volab/permisC2019/readme.rst

Infos générales Projet permis C 2019
======================================

   :Auteur:            `VoLAB <https://github.com/volab>`_
   :Projet:             Permis C 2019
   :dépôt_GitHub:       https://github.com/volab/permisC2019.git
   :documentation:      https://volab.github.io/permisC2019/ 
   :Licence:            CC BY-NC-SA 4.0
   :Liens:              https://creativecommons.org/licenses/by-nc-sa/4.0/ 

------------------------------------------------------------------------------------------
