volab/permisC2019/_01-docs/_01-userDoc/fiches_peda_pcb_sansvariable/robot_junior_ressource5.odt

(http://www.vorobotics.com/) Ressource numéro 5 Doc 1/1
Robot Junior | Comment développer un robot autonome ?

Découverte des actionneurs

Les moteurs à courant continu

Le déplacement du robot

Nous allons découvrir les moteurs à courant continu

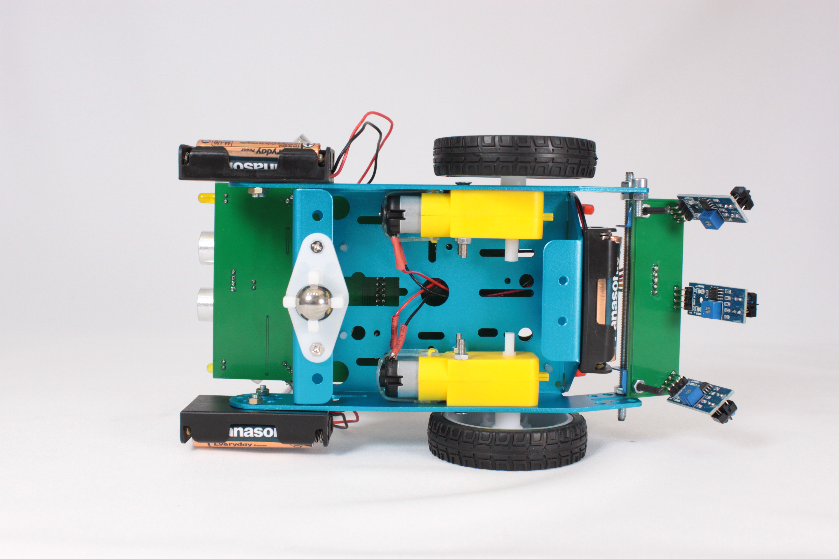
[picture p23: figure]

Moteur droit broche 12 (PWM)

Moteur droit broche 45 (sens 1 ou 0)

Moteur gauche broche 44 (PWM)

Moteur gauche broche 46 (sens 1 ou 0)

Le robot avance 1 seconde, s’arrête 1 seconde, recule 1 seconde et ensuite s’arrête 1 seconde. Le cycle se répète indéfiniment

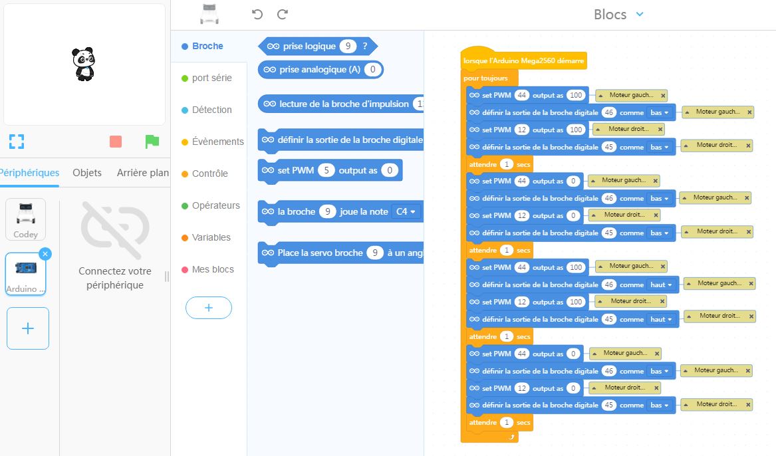
[picture p24: figure]

Association VoRoBotics
