volab/permisC2019/_02-realisation/_01-software/robot_junior_prog_maquette/programme de présentation.odt

Avancer

LEDs Avant

Obstacle Avant

Distance de sécurité (inertie)

Arrêt + feux Stop (LEDs Arrières)

Obstacle Avant

Reculer Ligne droite (distance aléatoire entre min et max)

LEDs Arrière + Buzzer

Obstacle Arrière

Arrêt + feux Stop (LEDs Arrière)

Retourner (orientation aléatoire entre min et max)

LEDs droites / gauches + Buzzer

Obstacle Arrière

Arrêt + feux Stop (LEDs Arrière)

Avancer

LEDs Avant
