volab/permisC2019/_01-docs/_01-userDoc/fiches_peda/doc_peda_pdf/robot_junior_ressource2.pdf

## Ressource numéro 2

## Découverte des actionneurs

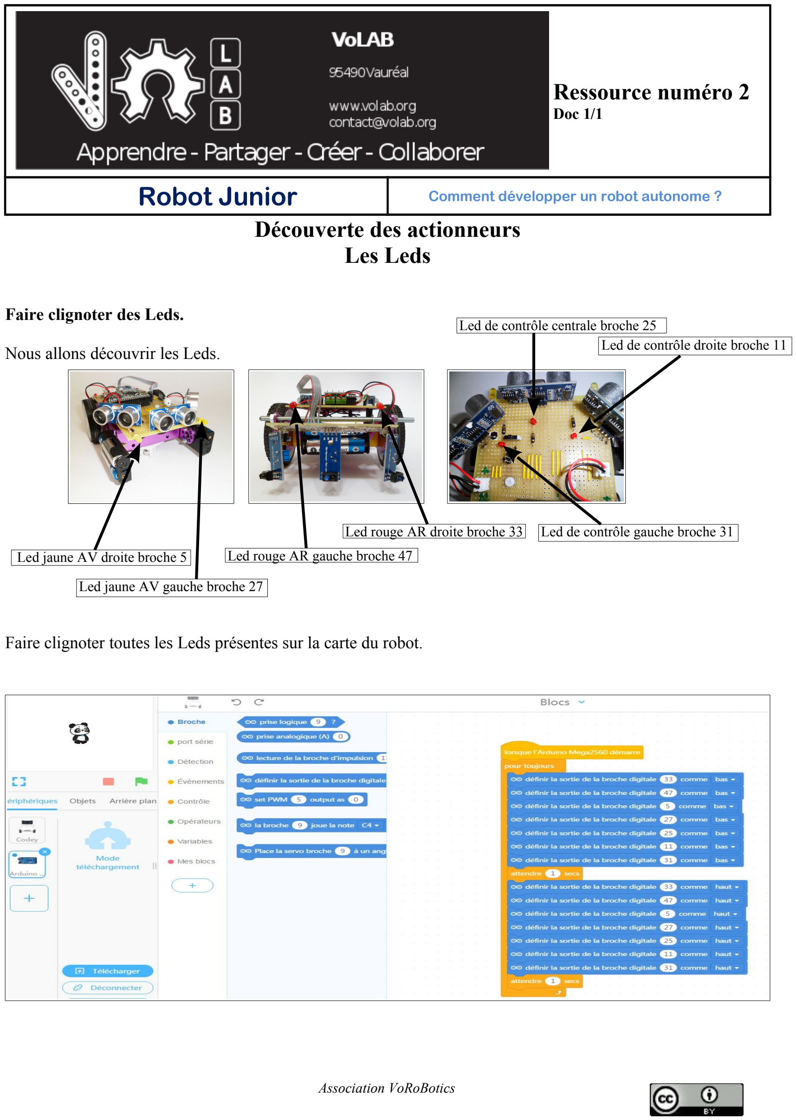
[picture p35: page 1]

Doc 1/1

Robot Junior | Comment développer un robot autonome ?

## Les Leds

Faire clignoter des Leds.

Nous allons découvrir les Leds.

Faire clignoter toutes les Leds présentes sur la carte du robot.

Association VoRoBotics

Led jaune AV droite broche 5

Led jaune AV gauche broche 27

Led rouge AR droite broche 33 Led rouge AR gauche broche 47

Led de contrôle centrale broche 25 Led de contrôle droite broche 11

Led de contrôle gauche broche 31
