volab/permisC2019/_01-docs/_01-userDoc/fiches_peda/doc_peda_pdf/robot_junior_ressource5.pdf

## Ressource numéro 5

## Découverte des actionneurs

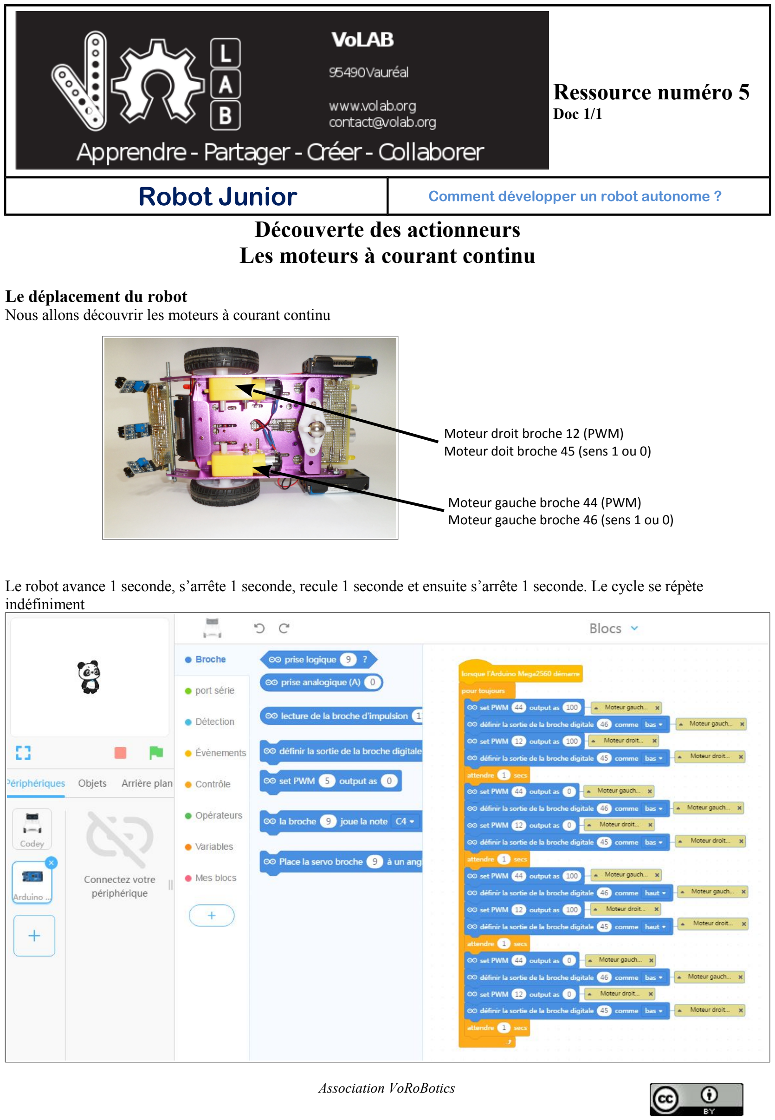
[picture p38: page 1]

Doc 1/1

Robot Junior | Comment développer un robot autonome ?

## Les moteurs à courant continu

Le déplacement du robot
Nous allons découvrir les moteurs à courant continu

Le robot avance 1 seconde, s’arrête 1 seconde, recule 1 seconde et ensuite s’arrête 1 seconde. Le cycle se répète indéfiniment

Association VoRoBotics

Moteur gauche broche 44 (PWM) Moteur gauche broche 46 (sens 1 ou 0)

Moteur droit broche 12 (PWM) Moteur doit broche 45 (sens 1 ou 0)
