volab/permisC2019/_01-docs/_01-userDoc/readme.rst

Dossier documentation du projet permis C 2019
===============================================

Voici l'arboresences du dossier _01-userDoc du projet:

.. code::

    +---fiches_peda
    |   |   
    |   +---doc_peda_pdf
    |   |       
    |   \---photos_robot
    |           
    +---fiches_peda_pcb_sansvariable
    |   |   
    |   +---photos_robot
    |   |       
    |   \---doc_peda_pcb_sansvariable_pdf
    |       |   
    |       \---monoPDF
    |               fiches_peda_merged.pdf
    |               
    \---documentionProjetToWeb

fiches_peda : contient la premeière version des fiches pédagogiques (celle de la maquette)

fiches_peda_pcb_sansvariable : contient les fiches de la version PCB et qui n'utilise pas 
de variables

documentionProjetToWeb : contient les fichiers sources de la documentation à destination de 
Github pages et transformées en html par Sphinx (cf https://github.com/poltergeist42/JDM )
