volab/permisC2019/_01-docs/_05-administratif/readme.rst

Dossier administratif du projet permisC 2019
==============================================
Ce dossier contient des documents permettant de gérer les ateliers du samedi matin.

Parmis les documetns intéressant on y trouve les sources aillant servi pour l'affiche et/ou flyer.
