volab/permisC2019/_01-docs/_01-userDoc/fiches_peda/robot_junior_ressource4.odt

(http://www.vorobotics.com/) Ressource numéro 4 Doc 1/1
Robot Junior | Comment développer un robot autonome ?

Découverte des actionneurs

Le buzzer

Faire sonner un buzzer

Nous allons découvrir le buzzer

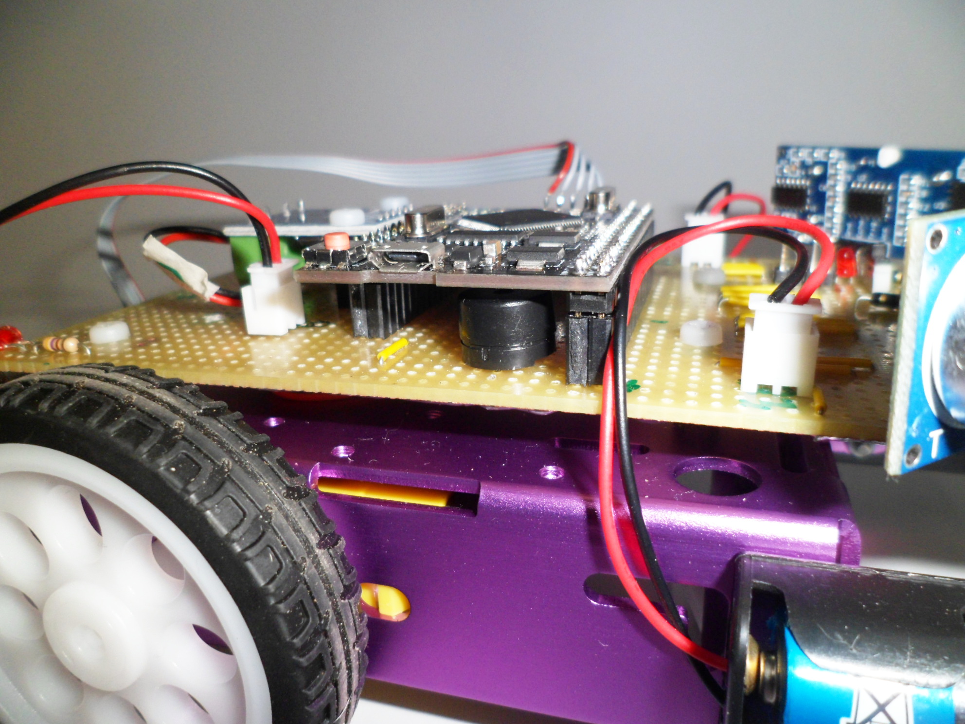
[picture p44: figure]

Buzzer

(raccordées sur la broche 4 de la carte)

Faire sonner le buzzer une seconde et l’éteindre.

Association VoRoBotics
