volab/permisC2019/_01-docs/_05-administratif/afficheA3_190903_2255.pdf

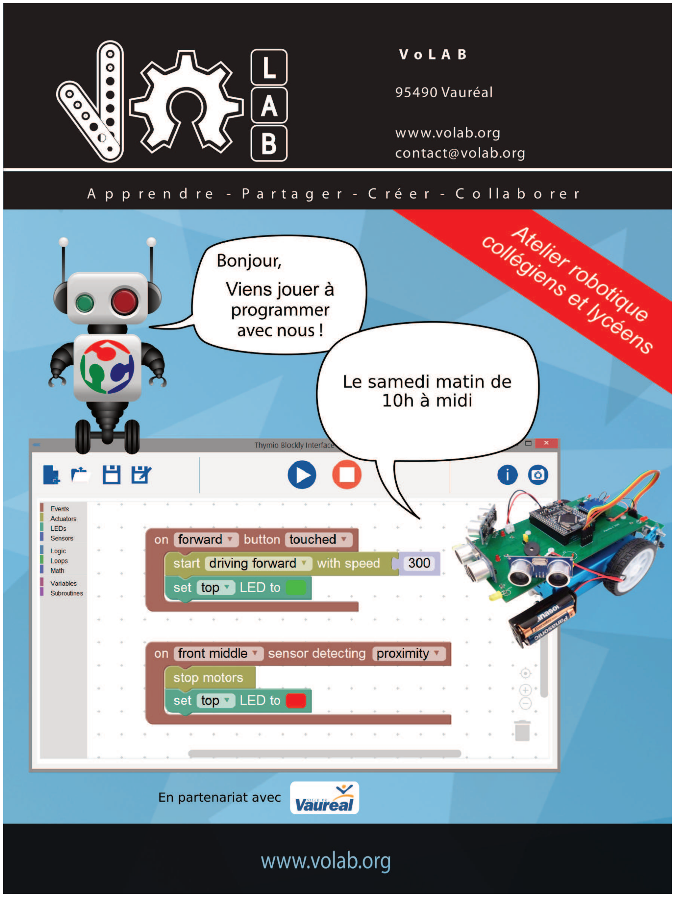
[picture p45: page 1]
