volab/permisC2019/_01-docs/_05-administratif/flyer_190903_2255.pdf

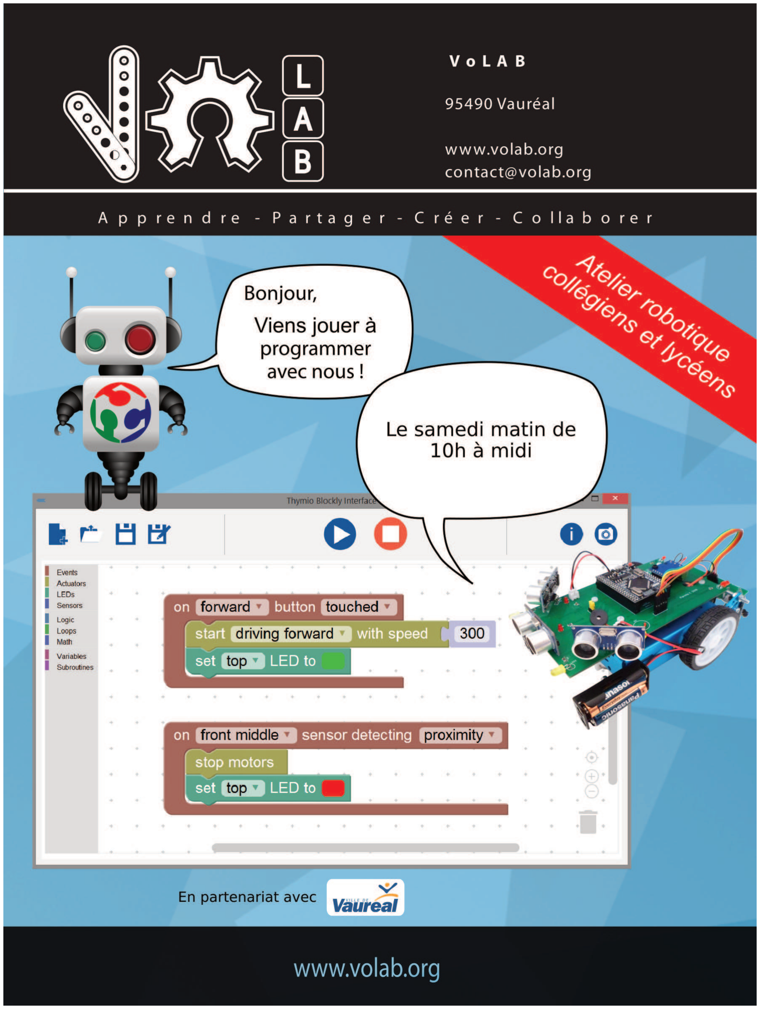
[picture p46: figure]
