volab/permisC2019/_01-docs/_01-userDoc/fiches_peda_pcb_sansvariable/doc_peda_pcb_sansvariable_pdf/robot_junior_ressource6.pdf

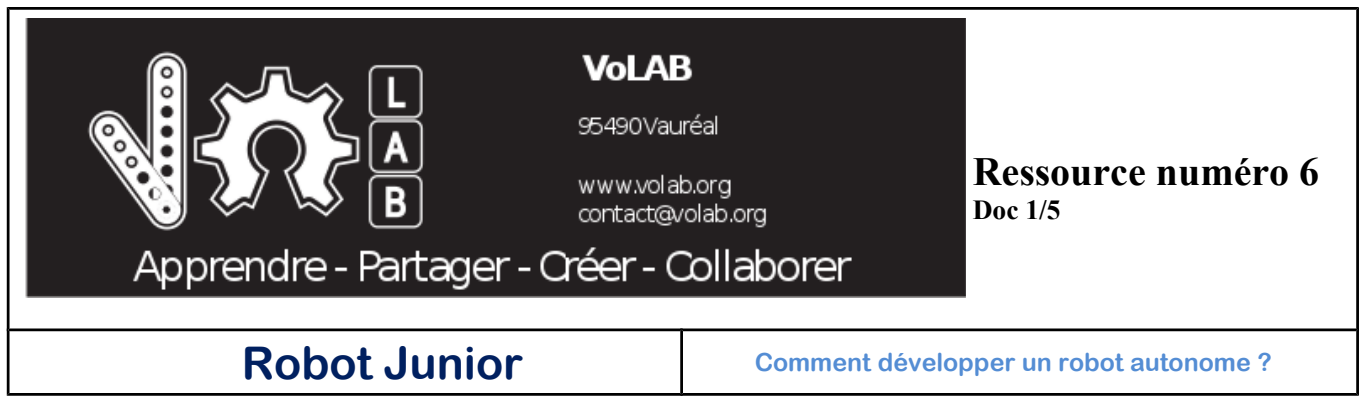
[picture p47: figure]
Ressource numéro 6; Doc 1/5

Robot Junior | Comment développer un robot autonome ?

## Programme final

Création des variables

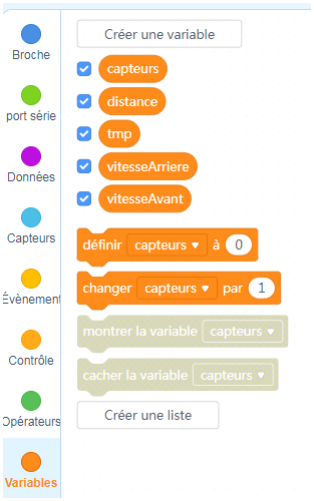
[picture p48: figure]

Association VoRoBotics

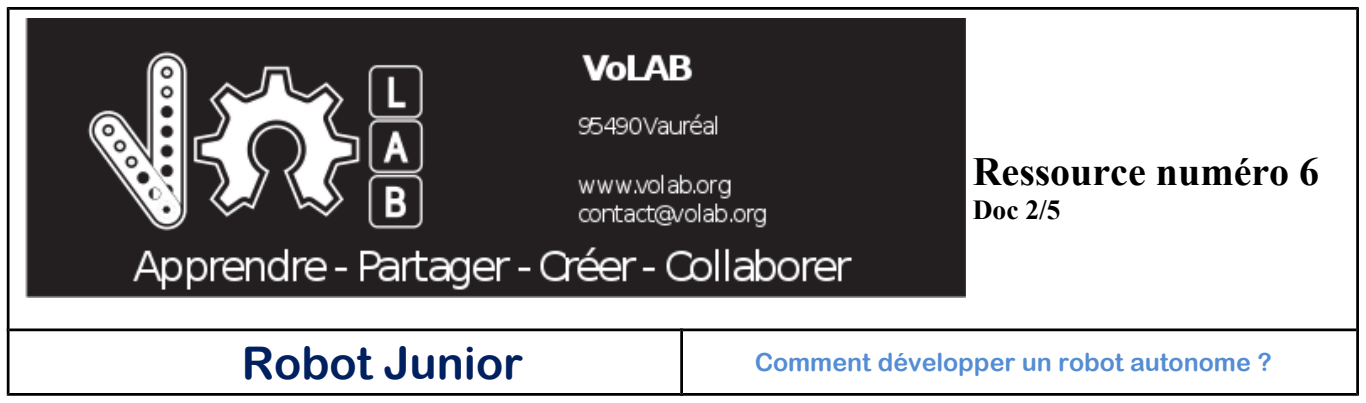
[picture p49: figure]
Ressource numéro 6; Doc 2/5

Robot Junior | Comment développer un robot autonome ?

Créer les blocs de détection

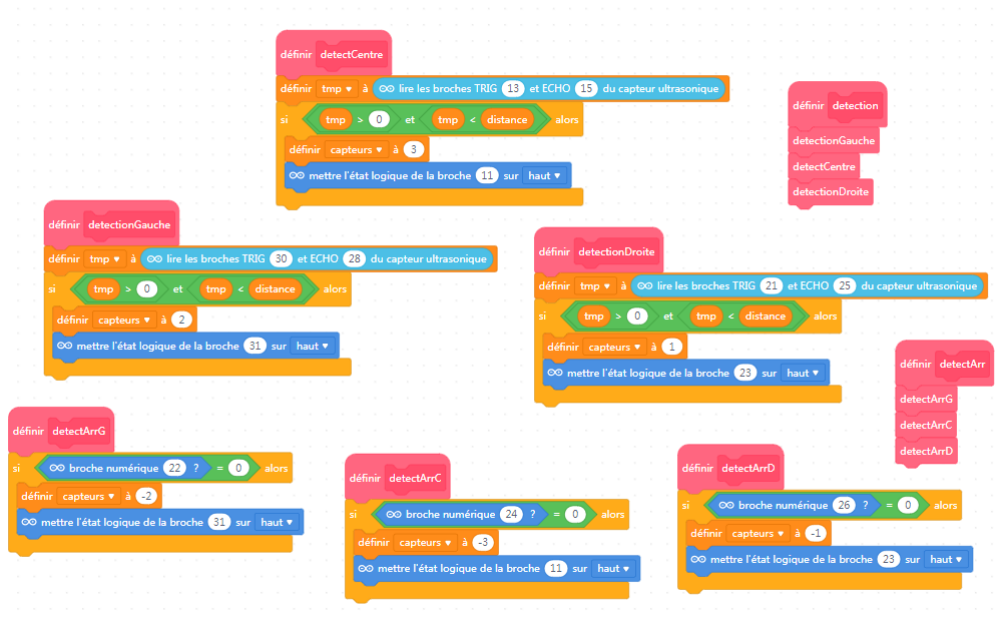
[picture p50: figure]

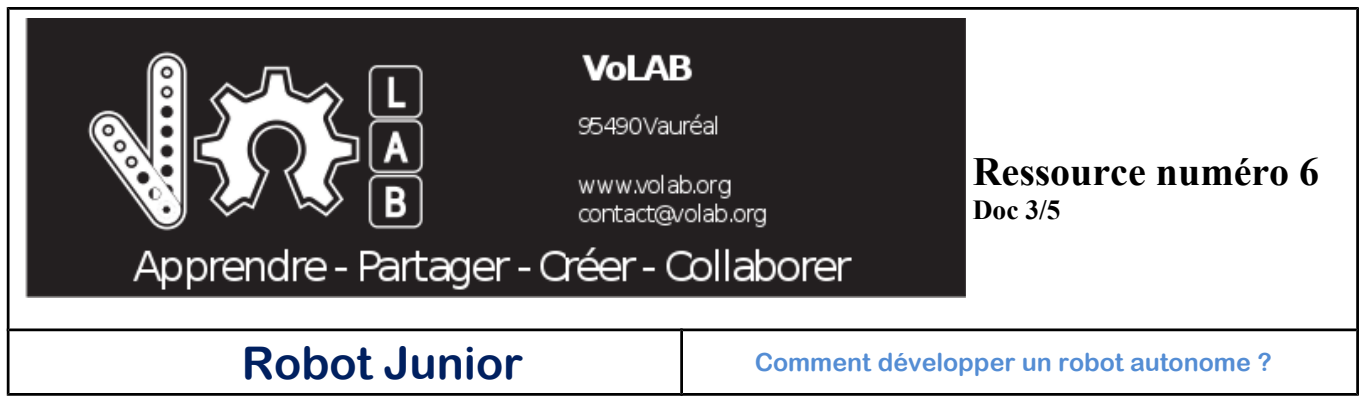
[picture p51: figure]
Ressource numéro 6; Doc 3/5

Robot Junior | Comment développer un robot autonome ?

Les blocs moteurs

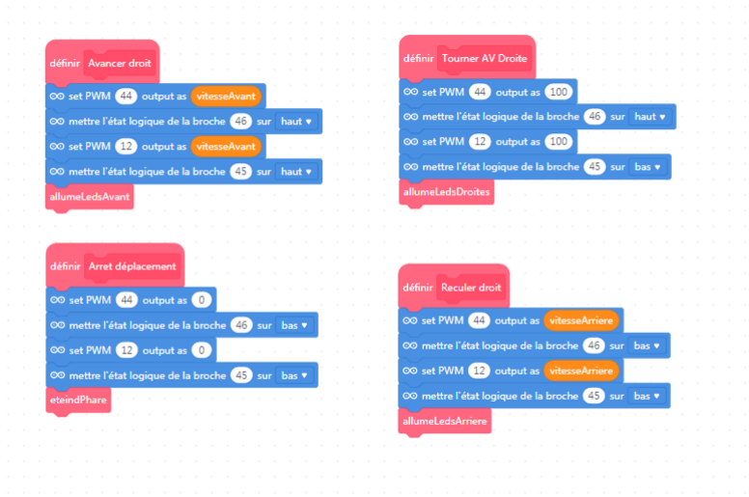
[picture p52: figure]

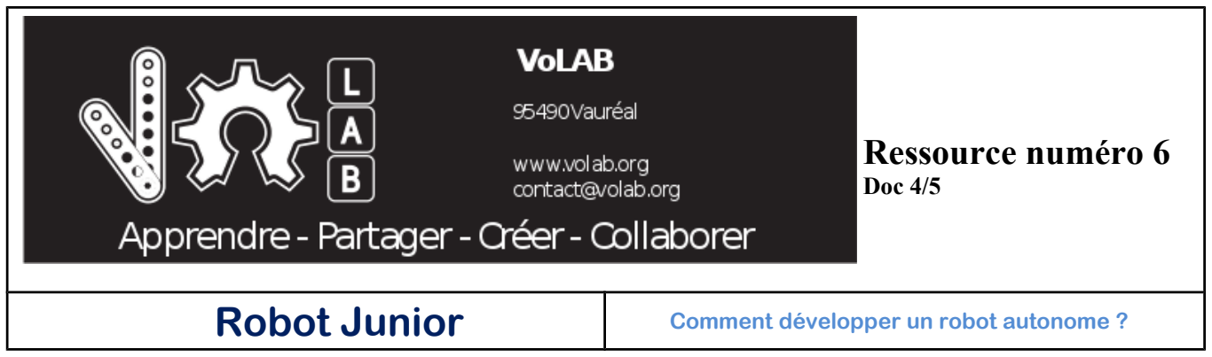
[picture p53: figure]
Ressource numéro 6; Doc 4/5

Robot Junior | Comment développer un robot autonome ?

Les blocs de gestion des LEDs

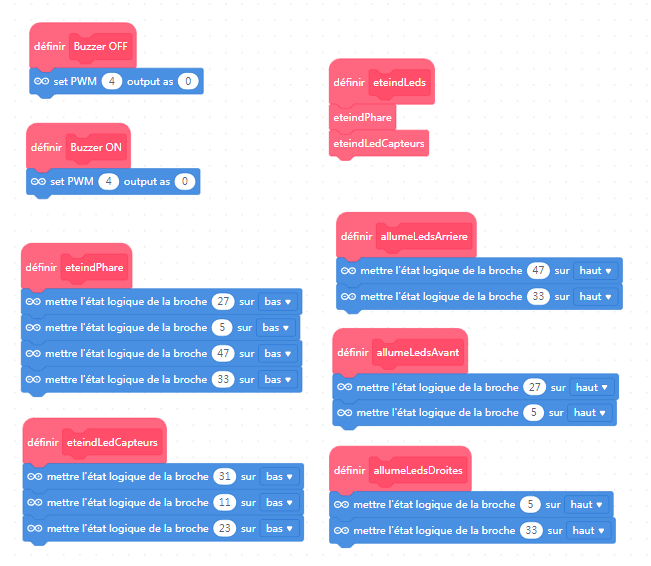
[picture p54: figure]

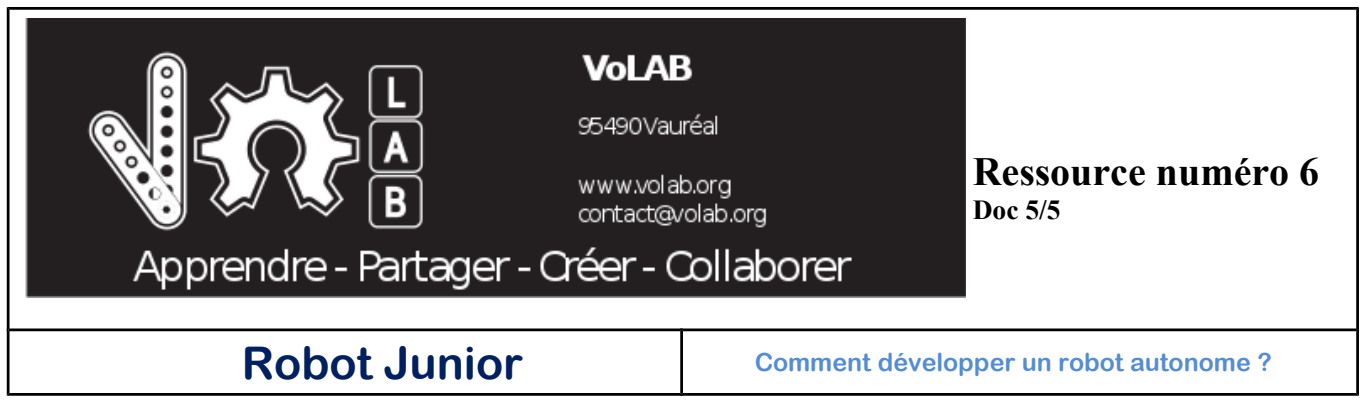
[picture p55: figure]
Ressource numéro 6; Doc 5/5

Robot Junior | Comment développer un robot autonome ?

### Programme principal

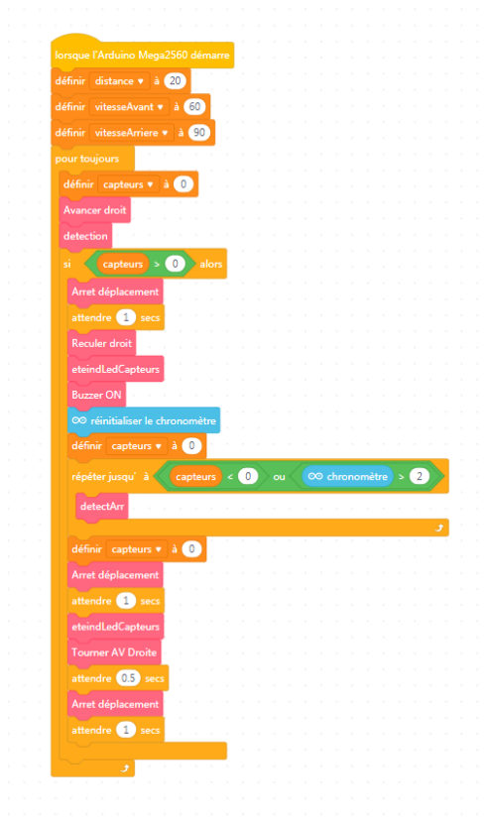
[picture p56: figure]
