volab/permisC2019/_01-docs/_01-userDoc/fiches_peda_pcb_sansvariable/doc_peda_pcb_sansvariable_pdf/robot_junior_ressource4.pdf

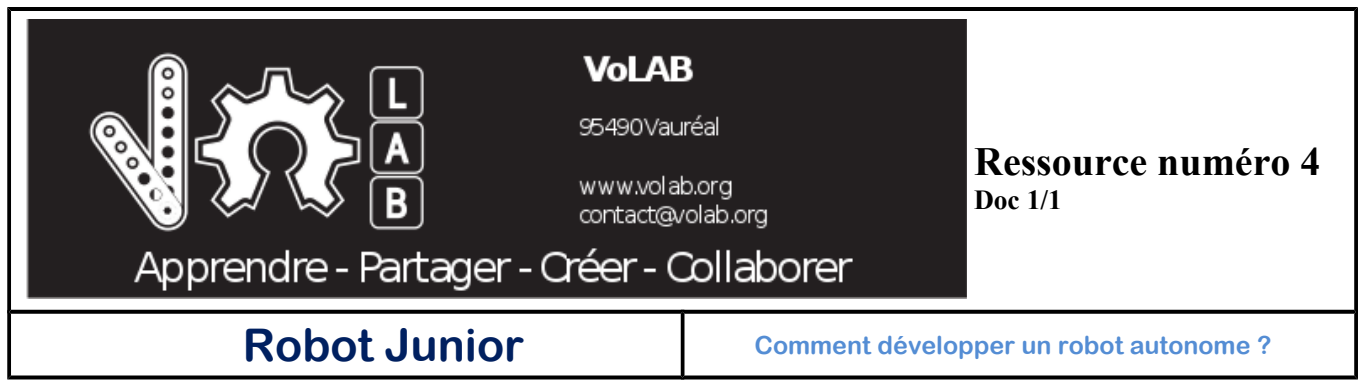
[picture p57: figure]
Ressource numéro 4; Doc 1/1

Robot Junior | Comment développer un robot autonome ?

### Découverte des actionneurs Le buzzer

Faire sonner un buzzer
Nous allons découvrir le buzzer

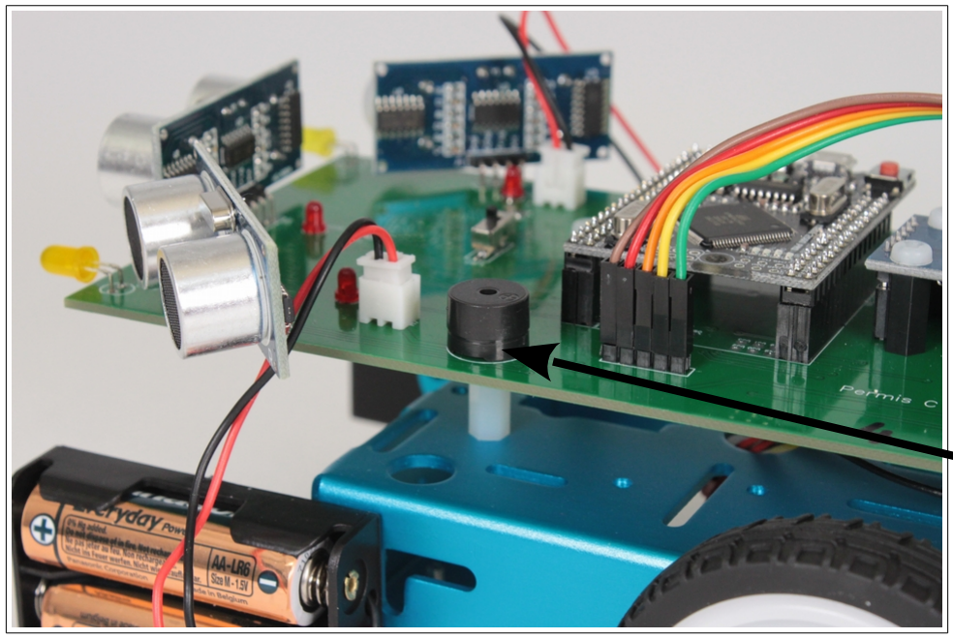
[picture p58: figure]

Faire sonner le buzzer une seconde et l’éteindre.

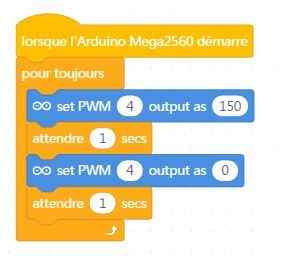
[picture p59: figure]

Association VoRoBotics

Buzzer
(raccordées sur la broche 4 de la carte)
