volab/permisC2019/_01-docs/_01-userDoc/blog/pmC2019_vueDes7robots_etagere.jpg

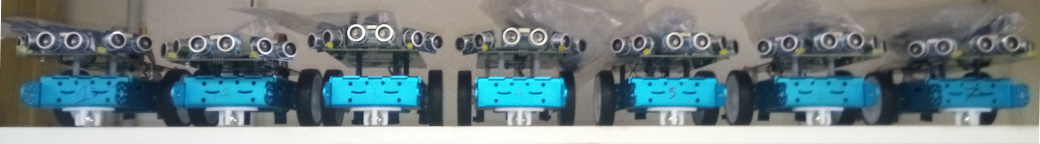
_01-docs/_01-userDoc/blog/pmC2019_vueDes7robots_etagere.jpg
