volab/permisC2019/_01-docs/_01-userDoc/documentionProjetToWeb/source/advanced/images/engrenage90inverse.jpg

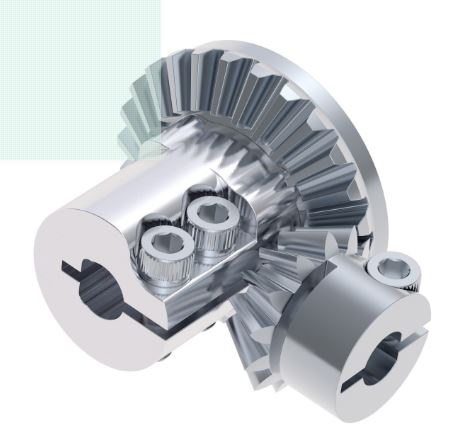
_01-docs/_01-userDoc/documentionProjetToWeb/source/advanced/images/engrenage90inverse.jpg
