volab/permisC2019/_01-docs/_01-userDoc/documentionProjetToWeb/source/advanced/images/moteur90Banggood.jpg

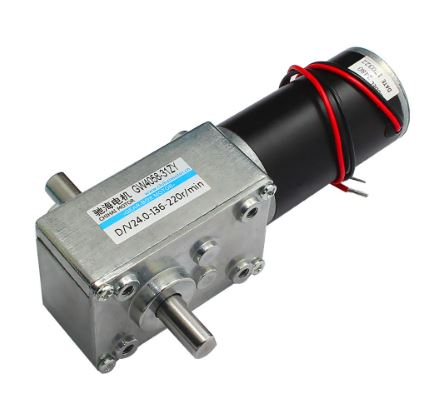
_01-docs/_01-userDoc/documentionProjetToWeb/source/advanced/images/moteur90Banggood.jpg
