volab/permisC2019/_01-docs/_01-userDoc/documentionProjetToWeb/source/images/buzerEtConnecteurPilesOriginal.JPG

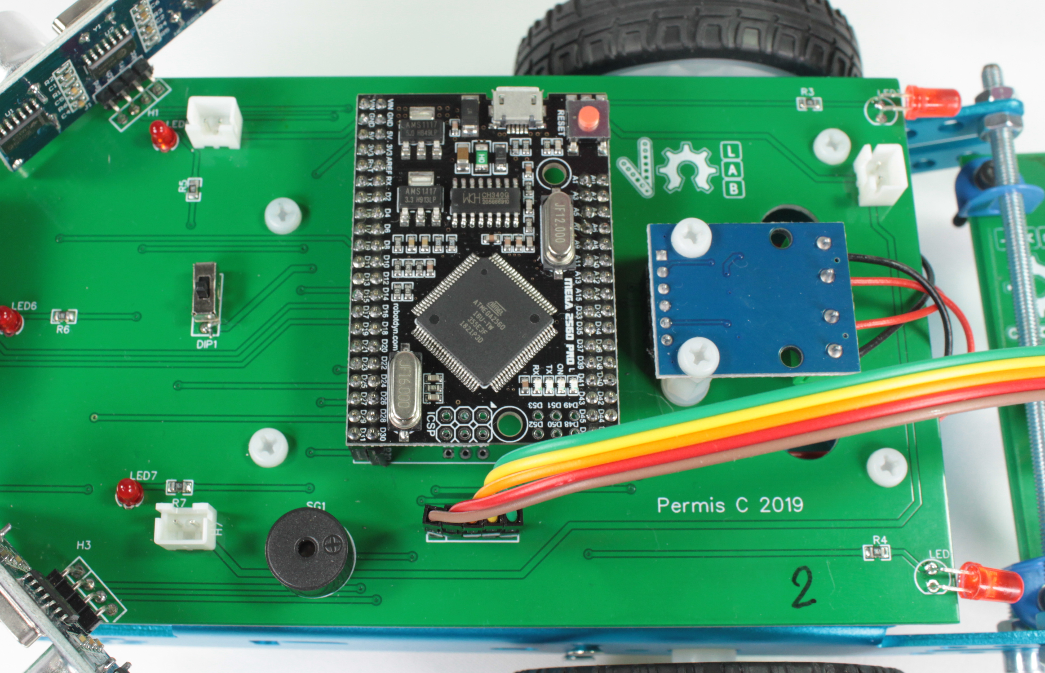
_01-docs/_01-userDoc/documentionProjetToWeb/source/images/buzerEtConnecteurPilesOriginal.JPG
