volab/permisC2019/_01-docs/_01-userDoc/documentionProjetToWeb/source/images/colonettes.jpg

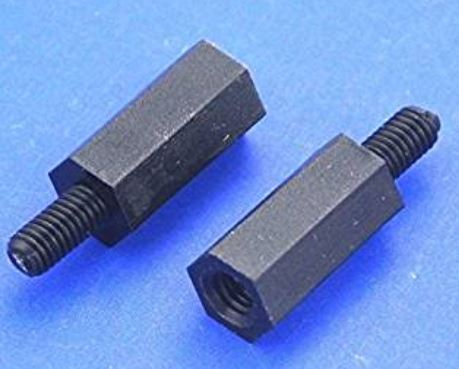
_01-docs/_01-userDoc/documentionProjetToWeb/source/images/colonettes.jpg
