volab/permisC2019/_01-docs/_01-userDoc/documentionProjetToWeb/source/images/detailConnecteurPile.jpg

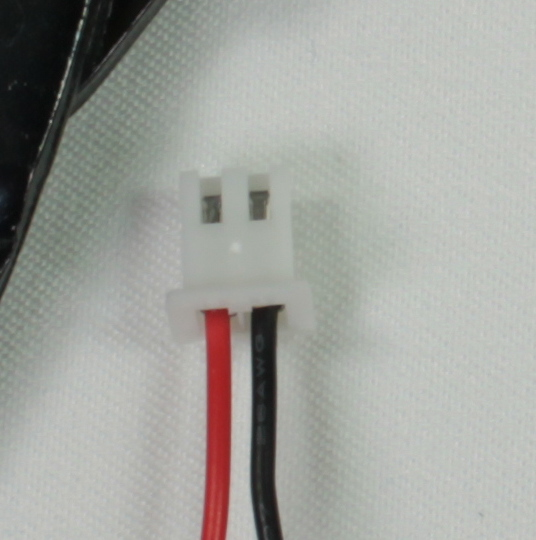
_01-docs/_01-userDoc/documentionProjetToWeb/source/images/detailConnecteurPile.jpg
