volab/permisC2019/_01-docs/_01-userDoc/fiches_peda/photos_robot/SAM_2332_ret.JPG

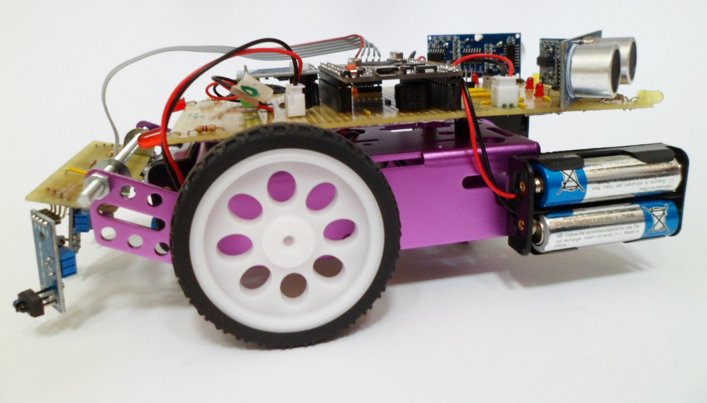
_01-docs/_01-userDoc/fiches_peda/photos_robot/SAM_2332_ret.JPG
