volab/permisC2019/_01-docs/_01-userDoc/fiches_peda/resumePin.svg.png

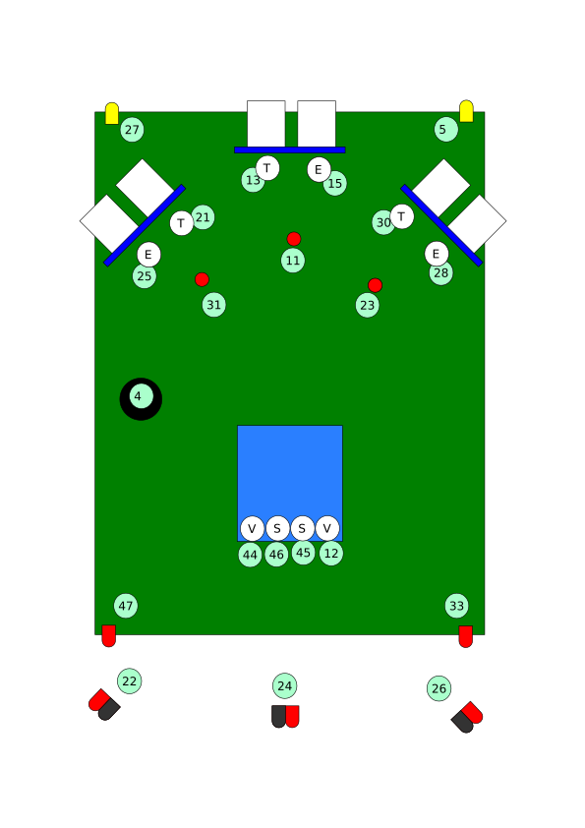
_01-docs/_01-userDoc/fiches_peda/resumePin.svg.png
