volab/permisC2019/_01-docs/_01-userDoc/fiches_peda_pcb_sansvariable/led_clignotant.JPG

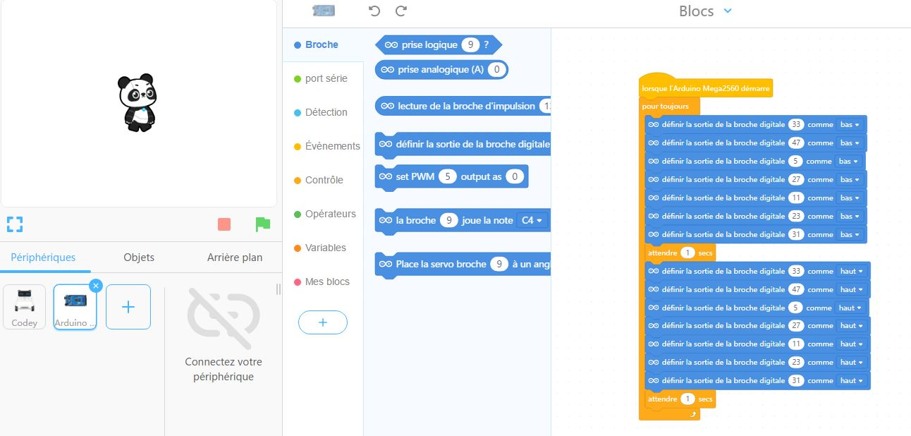
_01-docs/_01-userDoc/fiches_peda_pcb_sansvariable/led_clignotant.JPG
