volab/permisC2019/_01-docs/_01-userDoc/fiches_peda_pcb_sansvariable/photos_robot_V2/IMG_8770.JPG

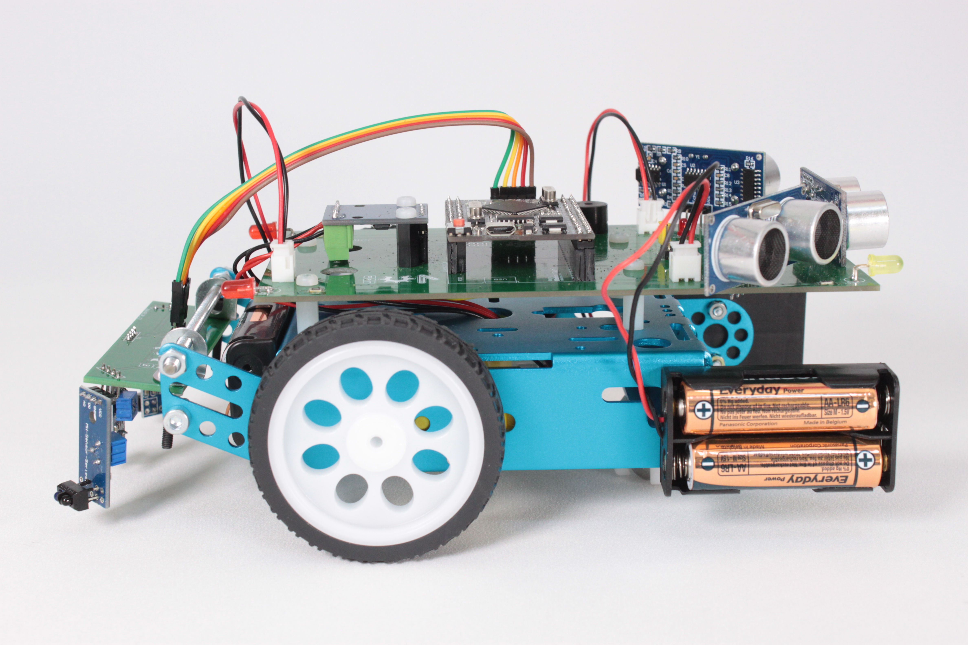
_01-docs/_01-userDoc/fiches_peda_pcb_sansvariable/photos_robot_V2/IMG_8770.JPG
