volab/permisC2019/_01-docs/_01-userDoc/wiki/permisC_2019_vignetteWiki.jpg

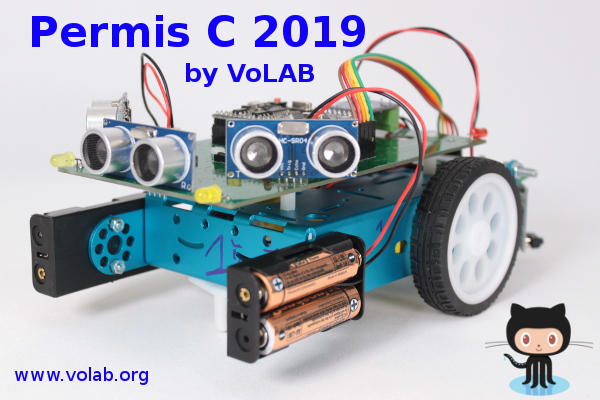
_01-docs/_01-userDoc/wiki/permisC_2019_vignetteWiki.jpg
