volab/permisC2019/_01-docs/_03-conception/easyEDAProjectCover.JPG

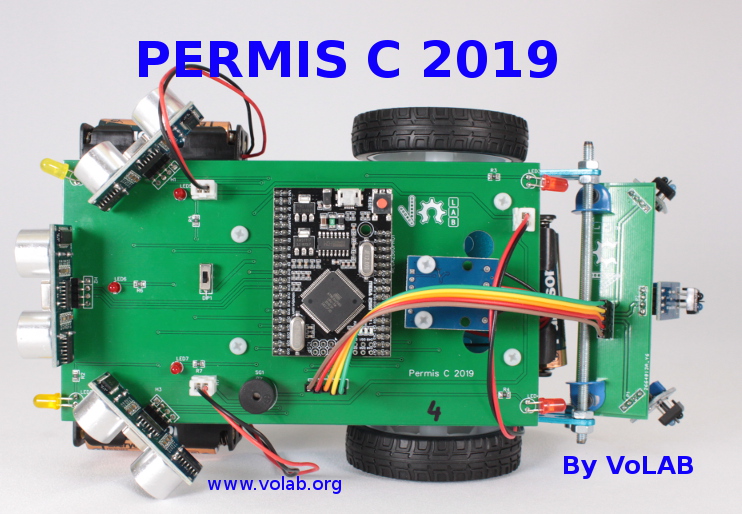
_01-docs/_03-conception/easyEDAProjectCover.JPG
