volab/permisC2019/_01-docs/_05-administratif/calendrier-vacances-2019-2020.png

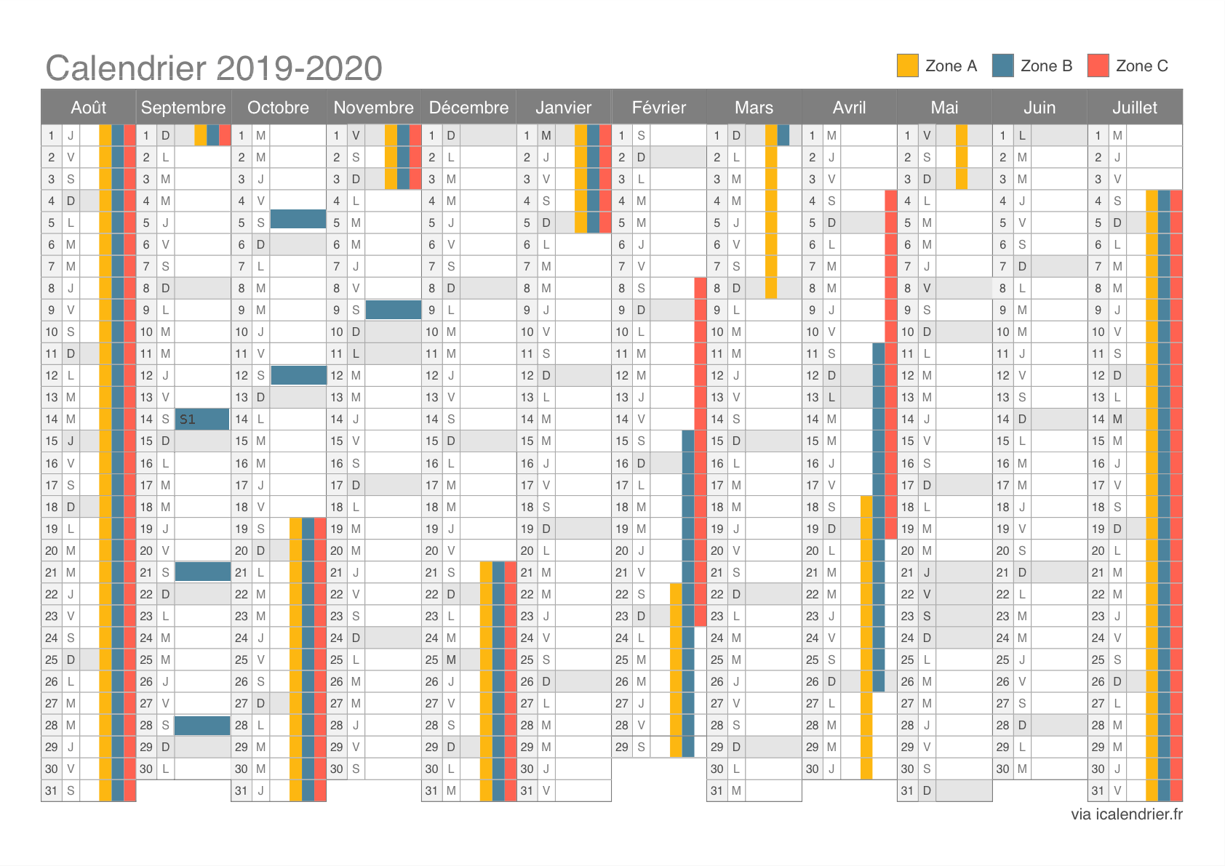
_01-docs/_05-administratif/calendrier-vacances-2019-2020.png
