volab/permisC2019/_01-docs/_05-administratif/photoPourVisuel.png

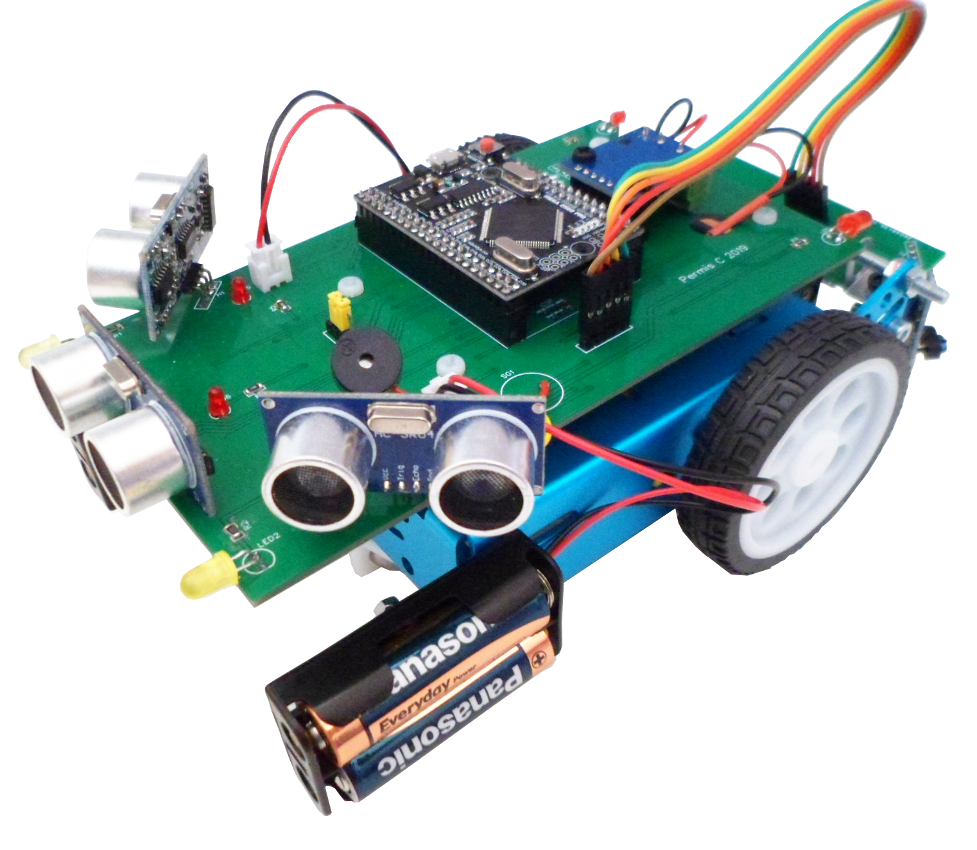
_01-docs/_05-administratif/photoPourVisuel.png
