volab/permisC2019/_02-realisation/_02-hardware/carteMaquette.JPG

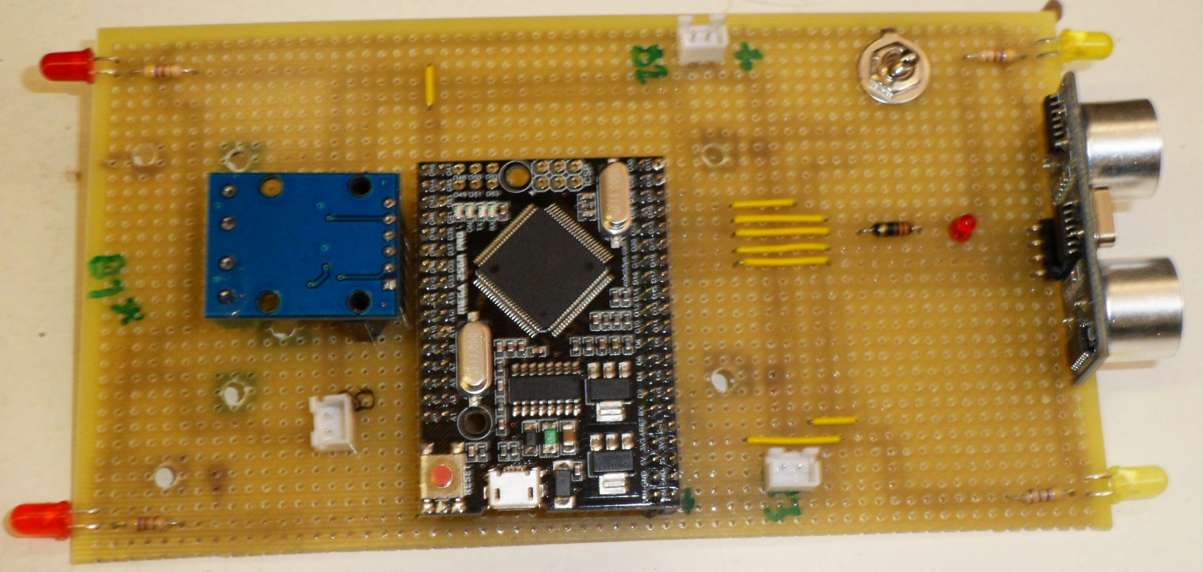
_02-realisation/_02-hardware/carteMaquette.JPG
