volab/permisC2019/_02-realisation/_02-hardware/SAM_2324.JPG

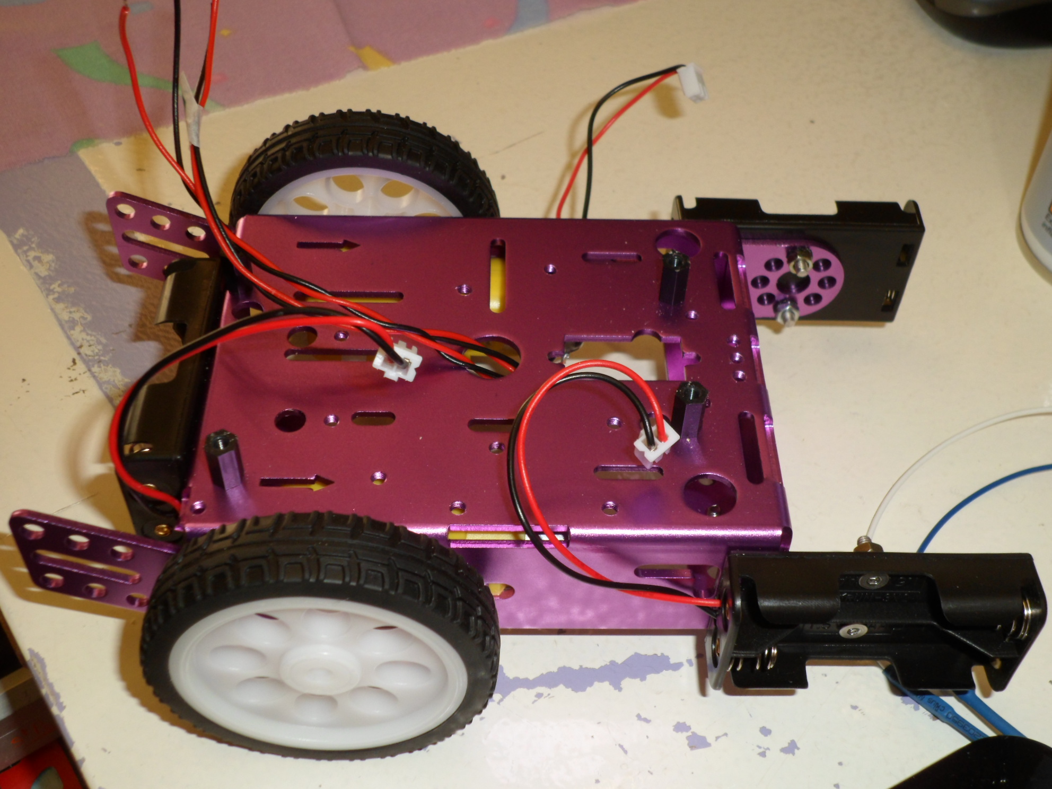
_02-realisation/_02-hardware/SAM_2324.JPG
