volab/permisC2019/_02-realisation/_03-cao_3D/2wd-robot-smart-car-aluminum-chassis-kit-set-a30-robotedu-1807-11-robotedu@4.jpg

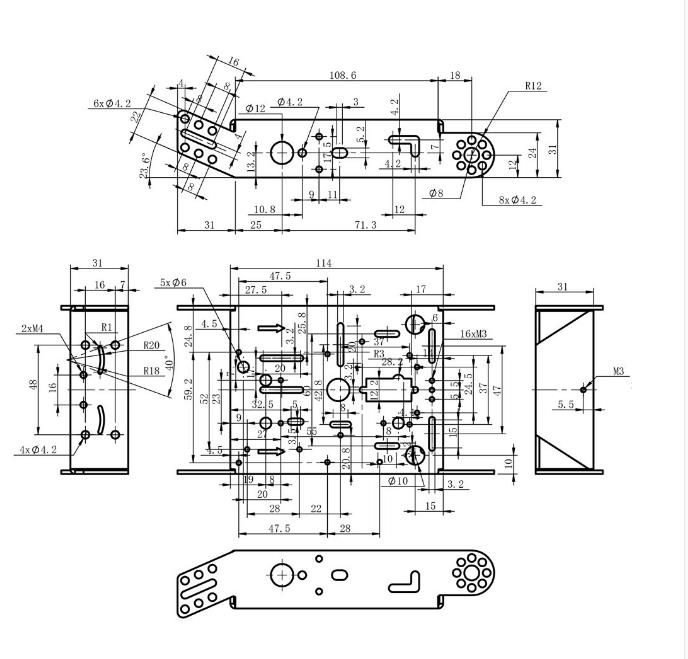
_02-realisation/_03-cao_3D/2wd-robot-smart-car-aluminum-chassis-kit-set-a30-robotedu-1807-11-robotedu@4.jpg
