volab/permisC2019/_02-realisation/_03-cao_3D/Aluminium Robot Chasis Dimension.jpg

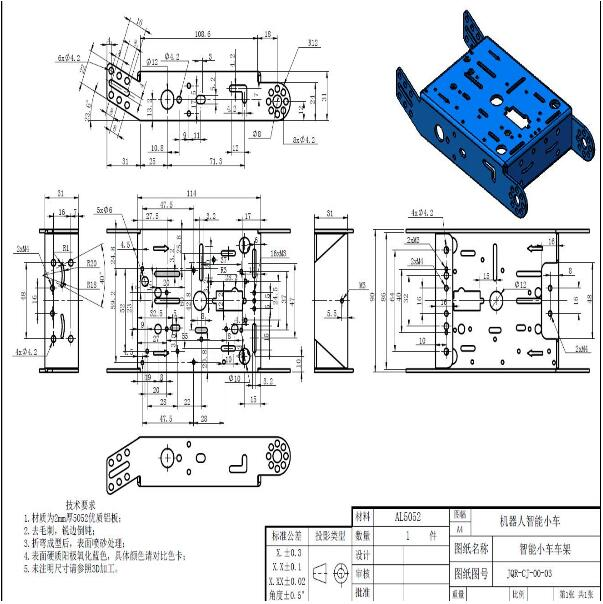
_02-realisation/_03-cao_3D/Aluminium Robot Chasis Dimension.jpg
