volab/permisC2019/_02-realisation/_03-cao_3D/TB2PflDvS8YBeNkSnb4XXaevFXa_!!2195813127-800x800.jpg

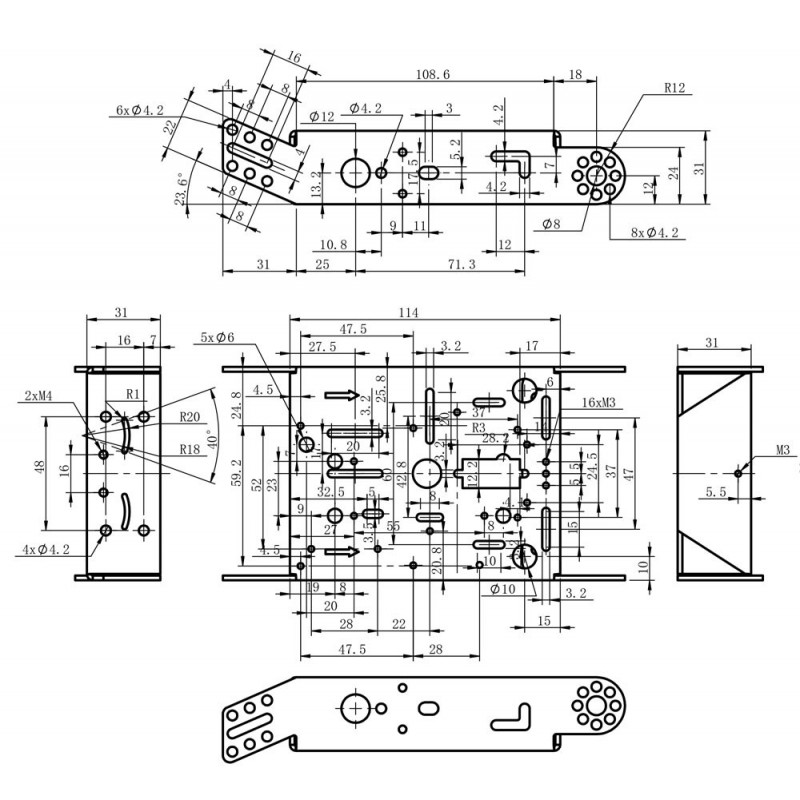
_02-realisation/_03-cao_3D/TB2PflDvS8YBeNkSnb4XXaevFXa_!!2195813127-800x800.jpg
