volab/permisC2019/_02-realisation/_02-hardware/liste_matos_190921_2203.ods

Projet robot junior Permis C 2019 |  |  |  |  |  |  |  |  |  | Nbr commande | 7
 | Besoin | UDV | Prix UDV | Prix unitaire | Prix pour 1 robot | Source | Commentaire | Besoin | On a | A commander | Commandé le | liv Prev |  | src AMAZON
Châssis + Moteurs + roues | 1 | 1 | 11,32 | 11,32 € | 11,32 € | Aliexpress (https://fr.aliexpress.com/item/32903186096.html) | free shiping. Disponibles aussi sur Amazon (https://www.amazon.fr/DOLITY-Motoréducteur-Débutant-Châssis-Voiture/dp/B07GJQHQM8) |  |  |  | 27/05/19 | 12/06/19 | Danguy
Arduino Mega 2560Pro | 1 | 1 | 8,11 | 8,11 € | 8,11 € | Aliexpress (https://fr.aliexpress.com/item/32801785024.html?scm_id=1007.13482.95643.0&scm-url=1007.13482.95643.0) | aussi ici : Bangood (https://www.banggood.com/fr/2X-1_5V-AA-Battery-Holder-Case-Enclosed-Box-OFFON-Switch-With-Wires-10pcs-p-1064329.html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) |  |  |  | 27/05/19 | 12/06/19 | Danguy
barette femelle 2,54mm | 85 | 400 | 2,21 | 0,01 € | 0,47 € | ebay (https://www.ebay.fr/itm/10Pcs-40-Pin-Single-Row-Female-2-54mm-Breakable-Header-Connector-For-Arduino/192938565736) |  | 595 | 60 | 2 | 4,42 |  |  | AMAZON (https://www.amazon.fr/Aussel-Breakaway-femelle-Connecteur-blindage/dp/B078SQ1CZF?__mk_fr_FR=ÅMÅŽÕÑ&s=gateway)
barette male 2,54 | 10 | 400 | 1,28 | 0,00 € | 0,03 € | Banggood (https://www.banggood.com/fr/10-Pcs-40-Pin-2_54mm-Single-Row-Male-Pin-Header-Strip-For-Arduino-p-918427.html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) |  | 70 | 100 | -1 | -1,28
LED 1000 pieces 4 couleurs | 4 | 1000 | 9,83 | 0,01 € | 0,04 € | Bangood (https://www.banggood.com/fr/1000pcs-5mm-LED-Blue-Green-Yellow-Red-White-Round-LED-Diode-Mixed-Color-Kit-p-1099483.html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) |  | 28 | 40 | -1 | -9,83
LED3mm | 3 | 100 | 1,8 | 0,02 € | 0,05 € | Aliexpress (https://fr.aliexpress.com/item/32888812567.html?s=p) |  | 21 | 30 | -1 | -1,8
10xBuzzer à courant continu | 1 | 10 | 1,4 | 0,14 € | 0,14 € | Bangood (https://fr.banggood.com/10pcs-3V-12V-Buzzer-16R-Resistance-AC-Passive-Buzzer-12085-p-1435460.html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) |  | 7 |  | 1 | 1,4
3xCapteur ultrason | 3 | 5 | 6,48 | 1,30 € | 3,89 € | Bangood (https://fr.banggood.com/5Pcs-HC-SR04-Ultrasonic-Ranging-Sensor-Ultrasonic-Module-For-Arduino-p-943142.html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) |  | 21 |  | 5 | 32,4
Bloc piles | 3 | 5 | 7,99 | 1,60 € | 4,79 € | AMAZON (https://www.amazon.fr/Haljia-Plastique-batterie-rangement-support/dp/B06WLHFXSH?__mk_fr_FR=ÅMÅŽÕÑ&s=gateway) | Ne pas acheter ceux là : Bangood (https://www.banggood.com/fr/2X-1_5V-AA-Battery-Holder-Case-Enclosed-Box-OFFON-Switch-With-Wires-10pcs-p-1064329.html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) | 21 | 9 | 3 | 23,97
Interrupteur | 1 | 20 | 1,07 | 0,05 € | 0,05 € | Bangood (https://fr.banggood.com/20pcs-SS12D00G3-2-Position-SPDT-1P2T-3-Pin-PCB-Panel-Mini-Vertical-Slide-Switch-p-1000847.html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) |  | 7 |  | 1 | 1,07 |  |  | AMAZON (https://www.amazon.fr/Cylewet-position-vertical-Interrupteur-glissière/dp/B06XSJLL9T)
PCB1 160x90 | 1 | 5 | 17,3 | 3,46 € | 3,46 € | jlpcb (https://jlcpcb.com/) | Sur EasyEDA (https://easyeda.com/VoLab-Team/eduRobot) | 7 |  | 2 | 34,6
PCB2 25*85 | 1 | 5 | 0 | 0,00 € | 0,00 € |  |  | 7 |  | 2 | 0
Résistance | 7 | 50 | 2 | 0,04 € | 0,28 € | RS (https://www.rs-particuliers.com/WebCatalog/Resistance_CMS_serie_CRG__boîtier_0805_valeur_330O__±1__0125W__±100ppm_°C-2230354.aspx) | Chez RS par lot de 50 330 en 0805 | 49 |  | 1 | 2
Cable pcb2 | 5 | 40 | 0,62 | 0,02 € | 0,08 € | Aliexpress (https://fr.aliexpress.com/item/32968969863.html?src=google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) | Attention au moment de la commande choisir la couleur F-F | 35 |  | 1 | 0,62 |  |  | AMZON (https://www.amazon.fr/NiceButy-Femelle-Dupont-Wire-électroniques/dp/B07HCBM83R?__mk_fr_FR=ÅMÅŽÕÑ&s=gateway)
fil rouge jauge 28 environ | 0,16
fil noir | 0,16
Connecteur pile XH 2,54 | 3 | 50 | 2,08 | 0,04 € | 0,12 € | aliexpress (https://fr.aliexpress.com/item/32683096009.html) |  | 21 |  | 1 | 2,08
infrarouge | 3 | 30 | 13,14 | 0,44 € | 1,31 € | BANGGOOD (https://www.banggood.com/30pcs-TCRT5000-Infrared-Reflective-Switch-IR-Barrier-Line-Track-Sensor-Module-p-1328594.html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) |  | 21 |  | 1 | 13,14
L9110S h-bridge moteur | 1 | 1 | 0,58 | 0,58 € | 0,58 € | Aliexpress (https://fr.aliexpress.com/item/2038557946.html) |  | 7 |  | 7 | 4,06 |  |  | AMAZON (https://www.amazon.fr/DollaTek-L9110S-Module-Moteur-motorisé/dp/B07DK4FMWR?__mk_fr_FR=ÅMÅŽÕÑ&s=gateway)
pile AA | 6 | 100 | 21,99 | 0,22 € | 1,32 € | AMAZON (https://www.amazon.fr/AmazonBasics-Lot-100-piles-alcalines-AA/dp/B01B8R6PF2?__mk_fr_FR=ÅMÅŽÕÑ&s=gateway) |  | 42 |  | 1 | 21,99
Condensateur 470uF/16V | 1
Visserie |  |  |  |  |  |  | Approvisionnement BRICOVIS (https://www.bricovis.fr/)
VIS TFHC M3x8 | 5 | 1 | 0,07 | 0,07 € | 0,35 € | TFHC03/008A10ZNEF |  | 35 | 50 | -15 | -1,05
VIS TCHC M3x8 | 6 | 1 | 0,06 | 0,06 € | 0,36 € | TCHC03/008A8ZNEF | support de piles, Il faut des têtes fraisées | 42 | 60 | -18 | -1,08
VIS TCHC M3x20 | 2 | 1 | 0,08 | 0,08 € | 0,16 € | TCHC03/020A8ZNEF |  | 14 | 20 | -6 | -0,48
Ecrou M3 | 8 | 1 | 0,01 | 0,01 € | 0,08 € | ECRHU03BR |  | 56 | 60 | -4 | -0,04
RONDELLE EVENTAIL M3 | 8 | 1 | 0,01 | 0,01 € | 0,08 € | RONAZ03NO |  | 56 |  | 56 | 0,56
VIS TCHC M4X12 | 1 | 1 | 0,05 | 0,05 € | 0,05 € | TCHC04/012A8ZNEF |  | 7 | 10 | -3 | -0,15
Ecrou M4 | 5 | 1 | 0,01 | 0,01 € | 0,05 € | ECRHU04ZN |  | 35 | 50 | -15 | -0,15
tige filtée M4 | 0,11 | 1 | 0,6 | 0,60 € | 0,07 € | TIGE04ZN |  | 0,77 | 1,1 | -1 | -0,6
RONDELLE PLATE M3 | 2 | 1 | 0,01 | 0,01 € | 0,02 € | RONL03ZN |  | 14 | 20 | -6 | -0,06
colonette M3x12 | 6 | 50 | 10,79 | 0,22 € | 1,29 € | AMAZON (https://www.amazon.fr/Electronics-Salon-filetée-hexagonale-Boulons-Entretoise/dp/B01G6UZ1Y2?__mk_fr_FR=ÅMÅŽÕÑ&s=gateway) | ENTH03/010MFZN | 42 |  | 1 | 10,79
equere | 2 | 1 | 0,07 | 0,07 € | 0,14 € | MECCANO (http://www.meccano-mr-productions.com/fr/24-equerre) |  | 14 | 20 | -6 | -0,42 |  | 7,32
M3x8 nylon | 6 |  |  |  |  |  |  | 42
 |  |  |  |  | 38,71 € |  |  |  |  |  | 136,16
PCB v2 |  |  |  |  |  |  |  |  |  |  | 15/08/19
colonette nylon AliExpress par 50pcs (https://fr.aliexpress.com/item/32841223758.html?src=google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) | 6 | 50 | 1,43 | 0,03 € | 0,17 €
embase pile | 3 | 8 | 6,07 | 0,76 € | 2,28 € | AMAZON (https://www.amazon.fr/sourcing-map-Batterie-Support-Rangement/dp/B0159MVGGK?__mk_fr_FR=ÅMÅŽÕÑ&s=gateway) |  | 21 |  | 3 | 18,21
Chassis chez ali express |  |  |  |  | 38,71 €
RS vrai barette séccable (https://www.rs-particuliers.com/WebCatalog/Embase_femelle_a_souder_sur_CI__45_Contacts__1_rangee__Traversant__Droit__au_pas_de_254mm-2304893.aspx)
