volab/permisC2019/_02-realisation/_03-cao_3D/mBot_motor_22mm.stp

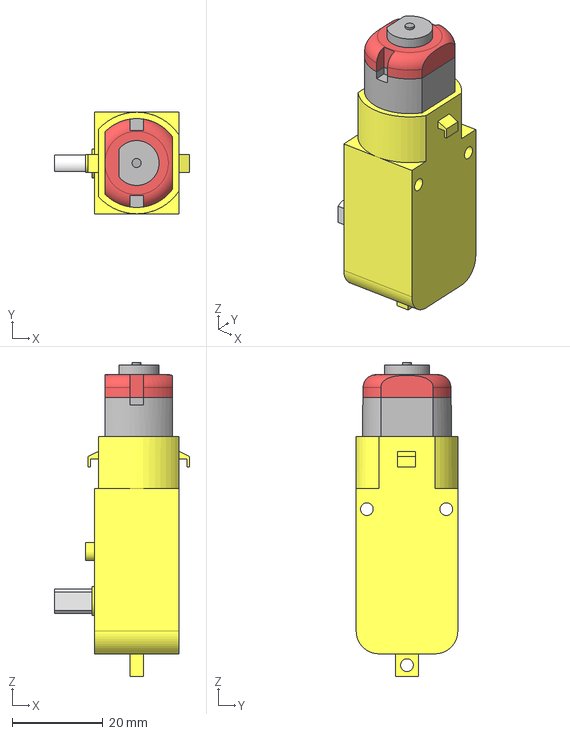
[picture p93: CAD file, 2019-09-14]
_02-realisation/_03-cao_3D/mBot_motor_22mm.stp
29.8 x 22.4 x 69.2 mm
