volab/permisC2019/_02-realisation/_03-cao_3D/mBot_Base.stp

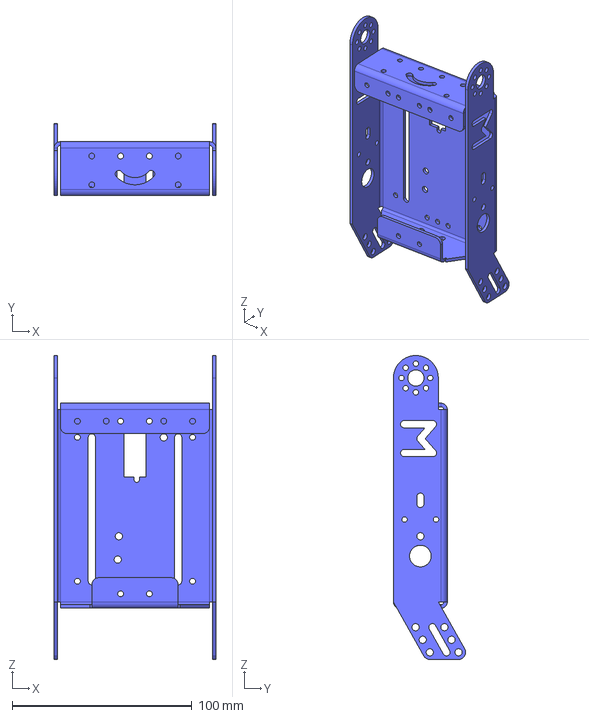
[picture p94: CAD file, 2019-09-14]
_02-realisation/_03-cao_3D/mBot_Base.stp
90.0 x 40.2 x 169.0 mm
