volab/permisC2019/_02-realisation/_04-test/testPcb20190813.docx

Test du pcb sous EasyEDA

13/08/2019

Résistance CMS mauvaise idée : changé sur le PCB 13/08/2019

Référence du buzzer : ok dans la liste des courses

Inter m/A ref : dans la liste des courses : inter à glissière changé sur le PCB : 13/08/2019

14/08/2019

Ré-install mblock v5.1.0

Tlc ok

Prog all led modifié _pcb : ok

Capteur us testés avec prog pcb

Buzzer ok

All is ok
