volab/permisC2019/_01-docs/_01-userDoc/fiches_peda_pcb_sansvariable/doc_peda_pcb_sansvariable_pdf/robot_junior_Annexe.pdf

### Ressource Annexe

### Rappel des broches utilisées

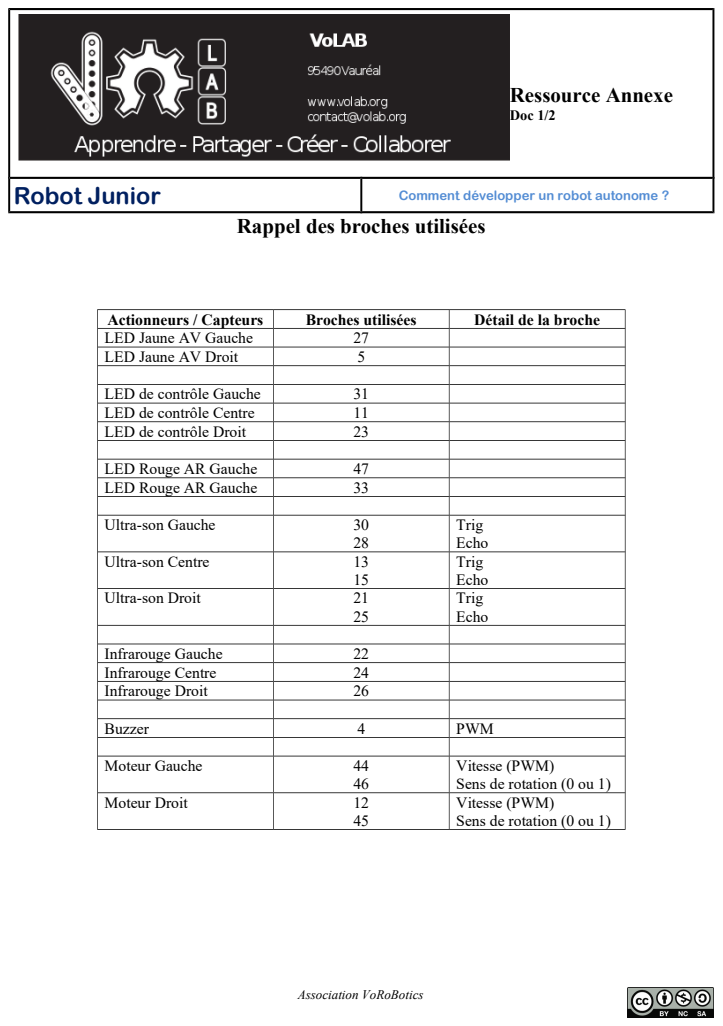
[picture p95: page 1]
Doc 1/2; Robot Junior; Comment développer un robot autonome ?; Actionneurs / Capteurs; Broches utilisées; Détail de la broche; LED Jaune AV Gauche; LED Jaune AV Droit; LED de contrôle Gauche; LED de contrôle Centre; LED de contrôle Droit; LED Rouge AR Gauche; Ultra-son Gauche; Trig Echo; Ultra-son Centre; Ultra-son Droit; Infrarouge Gauche; Infrarouge Centre; Infrarouge Droit; Buzzer; PWM; Moteur Gauche; Moteur Droit; Association VoRoBotics

Vitesse (PWM)
Sens de rotation (0 ou 1)

### Ressource Annexe

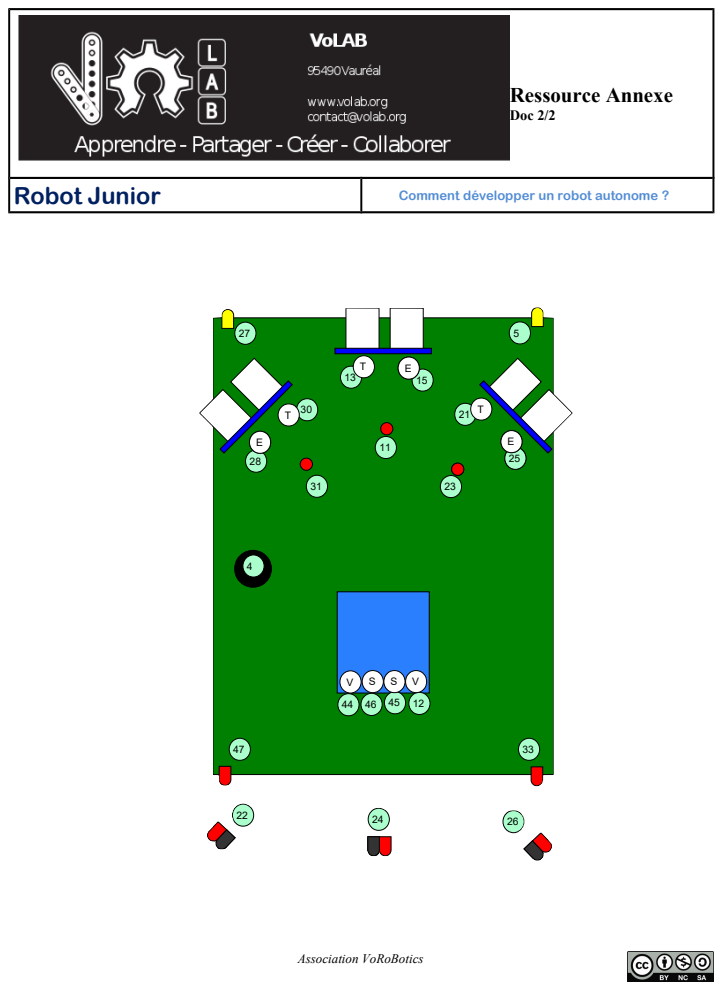
[picture p96: page 2]
Doc 2/2; Robot Junior; Comment développer un robot autonome ?; Association VoRoBotics
