volab/permisC2019/(commit log)

2019-09-14 Premier commit apres des mois de dur labeur
    [liste_mato_190914_1930.ods, mBot_Base.stp, mBot_motor_22mm.stp]
2019-09-14 install et conf de Sphinx
2019-09-14 Mise en place de la doc web
2019-09-18 maj doc admin + readme.rst
    [liste_mato_190914_1930.ods]
2019-09-28 grosse mise à jour documentaire
    [liste_mato_190914_1930.ods, liste_matos_190921_2203.ods]
2019-09-28 Concaténation de la doc.
2019-10-11 Maj doc et autres bricole
    [liste_mato_190914_1930.ods]
2019-10-11 maj doc capa ajoutée
    [liste_matos_190921_2203.ods]
2019-11-02 Version C++ fonctionnelle en mode suiveur de ligne
2019-11-02 Classe CRobotJunior opérationnelle en mode suiveur de ligne simple.
2019-11-02 avec chaine debug
2019-11-02 leds arrier activées
2019-11-12 version sans RF connecteur line follower ajouté entrée 6,8,10 et 14, 16, 18. Pour récup SPI.
2019-11-16 Telemetrie implementee dans le top level et fonctionnel mais pas encore dans la classe robot et ne transmet qu'une trame fixe avec un compteur toutes les secondes
    [NRF24Sol.ino, ligneFollow.ino]
2019-11-20 code instrumenté pour mlesure du temps de cycle avant nettoyage Serial.print et autre
2019-11-23 Version qui remont cpt++ avant passage à millis. Fonctionnelle (attention toutefois taille trame 14c et 460800bds dans la station sol).
2019-11-23 trame passée à 16c (pour le moment * à la fin. Objectif marquer le parcour grace aux capteurs ultrason
2019-11-23 Un commentaire write RF ! eh oui bon ben + essais de vitesse
2019-11-29 Essais vitesse / NRF24 / usSensor time out passé à 2900us
    [putty_tx_191126_2203_3m.xlsx, putty_tx_191126_2253_3m_90.log.xlsx, puttylog_tx_191123_1852.xls.xlsx, speeds.xlsx]
2019-11-29 Détection de perte de ligne op
    [speeds.xlsx]
2019-12-03 Version avec tentative de détection de tag sur le bord de la piste
    [speeds.xlsx]
2019-12-03 Mise au point des tag ok avec compteur pour évité les détection multiple. fonctionnel
2019-12-07 Machine d'état : état RECULE ok, etat RETRYVE ligne plus de détection intempestive.
2019-12-14 implementation timersynchrone
    [simplificationCapteur.xlsx, simplificationCapteur191214_1518.xlsx]
2019-12-14 Création stratégies d'alignement et validation en cours voir fichier Excel.
    [simplificationCapteur191214_1518.xlsx, speeds.xlsx]
2019-12-18 Tous les cas testé et validés avec 3 stratégies S0, S1, S2 souf 0,0
    [simplificationCapteur191214_1518.xlsx]
2019-12-20 Avant enrichissement version machine d'état. Cet essai avec plein de if n'est pas concluant.
2019-12-21 Réalignement fonctionnel version machine d'état même si de petits artéfacts persistent notament dans la jonction retrieve/realign surtout si realign arrive sur la ligne trop vite...
    [simplificationCapteur191214_1518.xlsx]
2019-12-21 Radio commenté pour pouvoir se passer de la station sol
